bullestock/balancebot/pcb/balancebot.kicad_pcb

## KiCad design pcb/balancebot.kicad_pcb (2019-05-28)

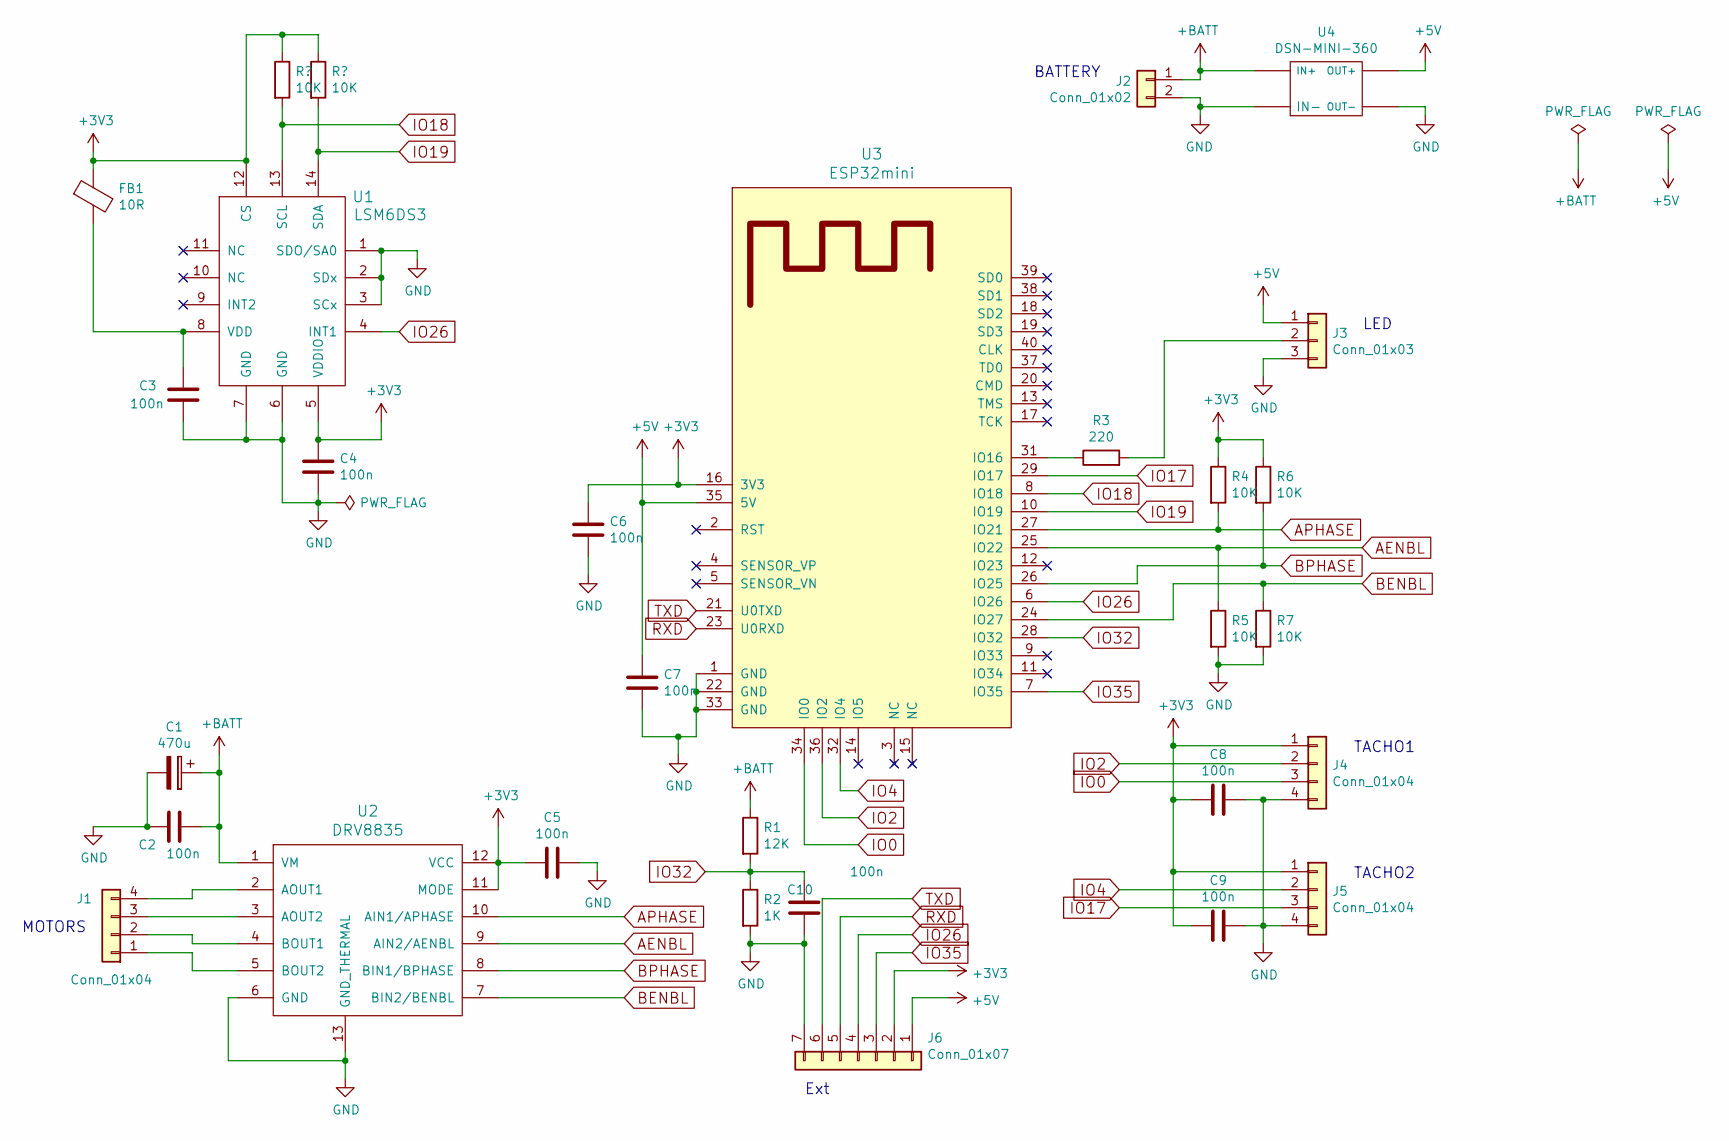
[picture p1: schematic balancebot.sch]

Parts:
C1: 470u; CP_Elec_8x10
C2, C3, C4, C5, C6, C7, C8, C9, C10: 100n; C_0603_1608Metric
FB1: 10R; L_0603_1608Metric
J1, J4, J5: Conn_01x04; JST_XH_B04B-XH-A_1x04_P2.50mm_Vertical
J2: Conn_01x02; JST_XH_B02B-XH-A_1x02_P2.50mm_Vertical
J3: Conn_01x03; JST_XH_B03B-XH-A_1x03_P2.50mm_Vertical
J6: Conn_01x07; JST_XH_B07B-XH-A_1x07_P2.50mm_Vertical
R1: 12K; R_0603_1608Metric
R2: 1K; R_0603_1608Metric
R3: 220; R_0603_1608Metric
R4, R5, R6, R7: 10K; R_0603_1608Metric
U1: LSM6DS3; LGA-14L
U2: DRV8835; WSON-12
U3: ESP32mini
U4: DSN-MINI-360

Connections:
+3V3: C4.1, C5.2, C6.1, C8.2, C9.2, FB1.1, J4.1, J5.1, J6.2, R4.1, R6.1, U1.5 (VDDIO), U1.12 (CS), U2.11 (MODE), U2.12 (VCC), U3.16 (3V3)
+5V: C7.1, J3.1, J6.1, U3.35 (5V), U4.OUT+
+BATT: C1.1, C2.1, J2.1, R1.1, U2.1 (VM), U4.IN+
AENBL: R5.1, U2.9 (AIN2/AENBL), U3.25 (IO22)
APHASE: R4.2, U2.10 (AIN1/APHASE), U3.27 (IO21)
BENBL: R7.1, U2.7 (BIN2/BENBL), U3.24 (IO27)
BPHASE: R6.2, U2.8 (BIN1/BPHASE), U3.26 (IO25)
GND: C1.2, C2.2, C3.2, C4.2, C5.1, C6.2, C7.2, C8.1, C9.1, C10.2, J2.2, J3.3, J4.4, J5.4, J6.7, R2.2, R5.2, R7.2, U1.1 (SDO/SA0), U1.2 (SDx), U1.3 (SCx), U1.6 (GND), U1.7 (GND), U2.6 (GND), U2.13 (GND_THERMAL), U3.1 (GND), U3.22 (GND), U3.33 (GND), U4.IN-, U4.OUT-
IO0: J4.3, U3.34 (IO0)
IO2: J4.2, U3.36 (IO2)
IO4: J5.2, U3.32 (IO4)
IO17: J5.3, U3.29 (IO17)
IO18: U1.13 (SCL), U3.8 (IO18)
IO19: U1.14 (SDA), U3.10 (IO19)
IO26: J6.4, U1.4 (INT1), U3.6 (IO26)
IO32: C10.1, R1.2, R2.1, U3.28 (IO32)
IO35: J6.3, U3.7 (IO35)
unnamed: C3.1, FB1.2, U1.8 (VDD)
unnamed: J1.1, U2.5 (BOUT2)
unnamed: J1.2, U2.4 (BOUT1)
unnamed: J1.3, U2.3 (AOUT2)
unnamed: J1.4, U2.2 (AOUT1)
unnamed: J3.2, R3.2
unnamed: R3.1, U3.31 (IO16)
RXD: J6.5, U3.23 (U0RXD)
TXD: J6.6, U3.21 (U0TXD)

Notes on the sheet:
LED
TACHO1
TACHO2
MOTORS
BATTERY
Ext

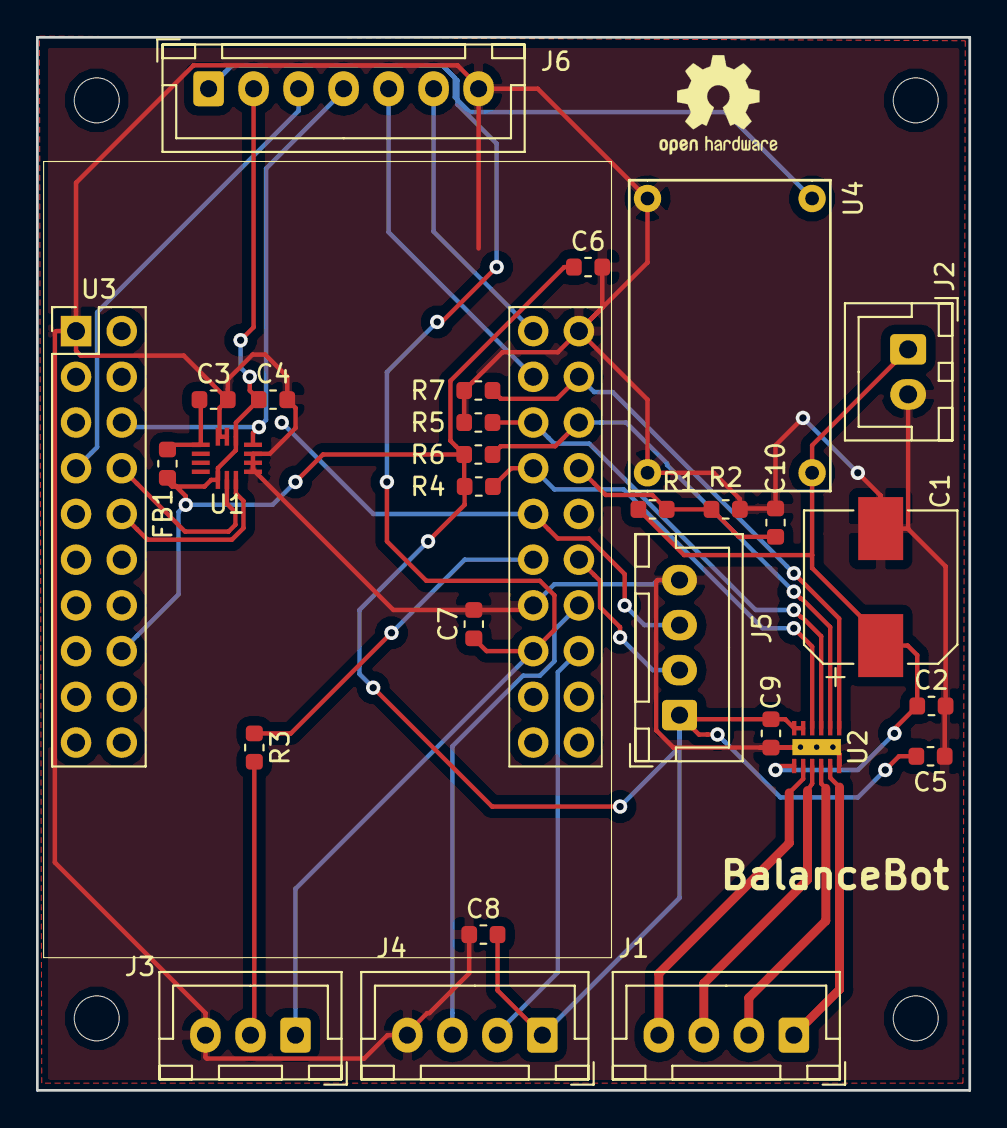
[picture p2: board balancebot.kicad_pcb from above]

Board: 2 copper layers, 51.8 x 58.5 mm, 28 parts (0 on the bottom side), 26 nets.
