bullestock/balancebot/esp32/main/main.cpp

#include <atomic>
#include <stdio.h>
#include <string.h>
#include <utility>

#include <freertos/FreeRTOS.h>
#include <freertos/queue.h>
#include <freertos/task.h>

#include <driver/adc.h>
#include <driver/ledc.h>
#include <driver/pcnt.h>

#include <lwip/sockets.h>

#include "esp_wifi.h"
#include "sdkconfig.h"
#include "esp_event.h"
#include "esp_sleep.h"
#include "nvs_flash.h"

#include "websocket_server.h"

#include "battery.h"
#include "console.h"
#include "espway.h"
#include "encoder.h"
#include "imu.h"
#include "imu_math.h"
#include "led.h"
#include "locks.h"
#include "motor.h"

#define LED_GPIO 16
#define LED_PIN 2 // internal

#define GPIO_APHASE_OUT 21
#define GPIO_AENBL_OUT  22
#define GPIO_BPHASE_OUT 25
#define GPIO_BENBL_OUT  27

#define GPIO_ENC_A1    2
#define GPIO_ENC_A2    0
#define GPIO_ENC_B1    4
#define GPIO_ENC_B2   17

#define PRIO_COMMUNICATION  2
#define PRIO_LED            0
#define PRIO_MAIN_LOOP      (TCPIP_THREAD_PRIO + 1)

Led* led = nullptr;
Motor* motor_a = nullptr;
Motor* motor_b = nullptr;
Encoder* enc_a = nullptr;
Encoder* enc_b = nullptr;
Imu* imu = nullptr;
Battery* battery = nullptr;
std::atomic<int32_t> looptime(0);

xQueueHandle pcnt_evt_queue;   // A queue to handle pulse counter events

mahony_filter_state imuparams;
static pidstate vel_pid_state;
static pidstate angle_pid_state;

SemaphoreHandle_t pid_mutex;
pidsettings pid_settings_arr[2];

static double target_speed = 0;
static double steering_bias = 0;

static SemaphoreHandle_t orientation_mutex;
vector3d gravity = {{ 0.0, 0.0, 1.0 }};

enum log_mode { LOG_FREQ, LOG_RAW, LOG_PITCH, LOG_NONE };

constexpr auto LOGMODE = LOG_FREQ;

#define ORIENTATION_STABILIZE_DURATION_US ((ORIENTATION_STABILIZE_DURATION) * 1000)
#define WINDUP_TIMEOUT_US ((WINDUP_TIMEOUT) * 1000)

static double sin_pitch = 0.0, sin_roll = 0.0;

static TaskHandle_t xCalculationTask = nullptr;

orientation get_orientation()
{
  orientation copy_orientation = {};
  {
    MutexLock lock(orientation_mutex);
    copy_orientation.sin_pitch = sin_pitch;
    copy_orientation.sin_roll = sin_roll;
  }
  return copy_orientation;
}

static SemaphoreHandle_t steering_mutex;

void set_steering(double new_target_speed, double new_steering_bias)
{
  {
    MutexLock lock(steering_mutex);
    target_speed = new_target_speed;
    steering_bias = new_steering_bias;
  }

  //!!if (xSteeringWatcher) xTaskNotify(xSteeringWatcher, 0, eNoAction);
}


double exponential_smooth(double prevVal, double newVal, double alpha)
{
    return prevVal + alpha * (newVal - prevVal);
}

int elapsed_time_us(TickType_t t2, TickType_t t1)
{
    return (t2 - t1)*portTICK_PERIOD_MS*1000;
}

void battery_cutoff()
{
    led->set_color(0, 0, 0);
    set_motors(0, 0);
    esp_deep_sleep_start();
}

void battery_task(void*)
{
    static bool shutdown = false;
    float smoothed_battery_value = battery->read_voltage();
    int send_counter = 0;
    while (1)
    {
        smoothed_battery_value = exponential_smooth(smoothed_battery_value, battery->read_voltage(), 0.05);
        if (smoothed_battery_value < BATTERY_THRESHOLD)
        {
            if (ENABLE_BATTERY_CUTOFF)
            {
                battery_cutoff();
                // Terminate task
                break;
            }
            else
            {
                disable_motors();
                if (!shutdown)
                {
                    led->set_color(0, 0, 0);
                    shutdown = true;
                    printf("SHUTDOWN: %f\n", smoothed_battery_value);
                }
            }
        }

        if (++send_counter > 20)
        {
            send_counter = 0;
            uint8_t buf[3];
            buf[0] = BATTERY;
            uint16_t* payload = (uint16_t*) &buf[1];
            payload[0] = static_cast<uint16_t>(smoothed_battery_value*1000);
            ws_server_send_bin_all(buf, sizeof(buf));
        }
        vTaskDelay(BATTERY_CHECK_INTERVAL / portTICK_PERIOD_MS);
    }
}

void steering_watcher(void *arg)
{
    while (1)
        if (!xTaskNotifyWait(0, 0, NULL, STEERING_TIMEOUT_MS / portTICK_PERIOD_MS))
        {
            steering_bias = 0;
            target_speed = 0;
        }
}

void led_task(void*)
{
    while (1)
    {
        led->update();
        vTaskDelay(100 / portTICK_PERIOD_MS);
    }
}

std::atomic<state> my_state(STABILIZING_ORIENTATION);
TickType_t stage_started = 0;
double smoothed_target_speed = 0;
double travel_speed = 0;
TickType_t last_wind_up = 0;
int64_t a_distance = 0;
int64_t b_distance = 0;
int a_speed = 0;
int b_speed = 0;

void init()
{
    my_state = STABILIZING_ORIENTATION;
    const TickType_t current_time = xTaskGetTickCount();
    stage_started = current_time;
    smoothed_target_speed = 0;
    travel_speed = 0;
    last_wind_up = current_time;
}

void main_loop(void* pvParameters)
{
    TickType_t time_last = xTaskGetTickCount();
    TickType_t current_time = 0;
    int n = 0;

    init();

    int loopcount = 0;
#define SHOW_DEBUG() 0 // (my_state == RUNNING)// && (loopcount == 0))

    led->set_color(Led::Init);

    int64_t last_enc_a_pos = 0;
    int64_t last_enc_b_pos = 0;
    
    while (1)
    {
        xTaskNotifyWait(0, 0, NULL, 1); // allow other tasks to run

        ++loopcount;
        if (loopcount >= 100)
        {
            loopcount = 0;

            const int64_t enc_a_pos = enc_a->poll();
            const int64_t enc_b_pos = enc_b->poll();
            a_speed = static_cast<int>(last_enc_a_pos - enc_a_pos);
            b_speed = static_cast<int>(last_enc_b_pos - enc_b_pos);
            last_enc_a_pos = enc_a_pos;
            last_enc_b_pos = enc_b_pos;
            a_distance += a_speed;
            b_distance += b_speed;
        }

        // 700 us
        int16v3 raw_data_accel, raw_data_gyro;
        if (!imu->read_raw_data(raw_data_accel, raw_data_gyro))
        {
            printf("Reading IMU failed\n");
            continue;
        }

        // Update orientation estimate
        // < 100 us
        {
            MutexLock lock(orientation_mutex);
            mahony_filter_update(&imuparams, raw_data_accel, raw_data_gyro, gravity);
            // Calculate sine of pitch angle from gravity vector
            sin_pitch = -gravity.data[IMU_FORWARD_AXIS];
            if (IMU_INVERT_FORWARD_AXIS)
                sin_pitch = -sin_pitch;
            sin_roll = -gravity.data[IMU_SIDE_AXIS];
            if (IMU_INVERT_SIDE_AXIS)
                sin_roll = -sin_roll;
        }

        // Exponential smoothing of target speed
        
        double motor_bias;
        {
            MutexLock lock(orientation_mutex);
            smoothed_target_speed = exponential_smooth(smoothed_target_speed,
                                                       target_speed, TARGET_SPEED_SMOOTHING);
            motor_bias = steering_bias;
        }

        current_time = xTaskGetTickCount();

        //printf("sin_pitch %f sin_roll %f\n", sin_pitch, sin_roll);
        
        if (my_state == STABILIZING_ORIENTATION &&
            elapsed_time_us(current_time, stage_started) > ORIENTATION_STABILIZE_DURATION_US)
        {
            led->set_color(Led::Stabilized);
            printf("Done stabilizing at %u\n", current_time);
            printf("sin_pitch %f sin_roll %f\n", sin_pitch, sin_roll);
            my_state = RUNNING;
            last_wind_up = current_time;
            imuparams.Kp = MAHONY_FILTER_KP;
        }
        else if (my_state == WOUND_UP)
        {
            if (fabs(sin_pitch - STABLE_ANGLE) < RECOVER_LIMIT)
            {
                printf("Try again!\n");
                init();
            }
        }
        else if (my_state == RUNNING)
        {
            if (fabs(sin_pitch - STABLE_ANGLE) < FALL_LIMIT &&
                fabs(sin_roll) < ROLL_LIMIT)
            {
                // Perform PID update
                double target_angle, motor_speed;
                {
                    MutexLock lock(pid_mutex);
                    target_angle = pid_compute(travel_speed, smoothed_target_speed,
                                               &pid_settings_arr[VEL], &vel_pid_state,
                                               SHOW_DEBUG());
                    if (sin_pitch < (target_angle - HIGH_PID_LIMIT))
                        motor_speed = -1.0;
                    else if (sin_pitch > target_angle + HIGH_PID_LIMIT)
                        motor_speed = 1.0;
                    else
                        motor_speed = pid_compute(sin_pitch, target_angle,
                                                  &pid_settings_arr[ANGLE], &angle_pid_state,
                                                  SHOW_DEBUG());
                    if (SHOW_DEBUG())
                        printf("Angle Kp %f motor_speed %f\n", pid_settings_arr[ANGLE].Kp, motor_speed);
                }

                if (fabs(motor_speed) < MOTOR_DEADBAND)
                    motor_speed = 0;

                if (my_state == WOUND_UP)
                    set_motors(0, 0);
                else
                    set_motors(motor_speed + motor_bias,
                               motor_speed - motor_bias);

                if (motor_speed != 1.0 && motor_speed != -1.0)
                    last_wind_up = current_time;
                else
                {
                    const auto us_since_last_windup = elapsed_time_us(current_time, last_wind_up);
                    if (us_since_last_windup > WINDUP_TIMEOUT_US)
                    {
                        set_motors(0, 0);
                        if (my_state != WOUND_UP)
                            printf("WOUND UP at %u (%d)\n", current_time, us_since_last_windup);
                        my_state = WOUND_UP;
                        led->set_colors(100, Led::WoundUp, Led::None);
                        //vTaskDelay(100/portTICK_PERIOD_MS);
                    }
                }

                // Estimate travel speed by exponential smoothing
                travel_speed = exponential_smooth(travel_speed, motor_speed,
                                                  TRAVEL_SPEED_SMOOTHING);
            }
            else
            {
                printf("FALLEN!\n");
                my_state = FALLEN;
                led->set_colors(50, Led::Fallen, Led::None);
                travel_speed = 0;
                smoothed_target_speed = 0;
                set_motors(0, 0);
            }
        }
        else if (my_state == FALLEN &&
                 fabs(sin_pitch - STABLE_ANGLE) < RECOVER_LIMIT &&
                 fabs(sin_roll) < ROLL_LIMIT)
        {
            printf("Running again!\n");
            my_state = RUNNING;
            last_wind_up = current_time;
            led->set_color(Led::Running);
            pid_reset(sin_pitch, 0, &pid_settings_arr[ANGLE], &angle_pid_state);
            pid_reset(0, STABLE_ANGLE, &pid_settings_arr[VEL],
                      &vel_pid_state);
        }

        if (LOGMODE == LOG_FREQ)
        {
            ++n;
            if (n == 1000)
            {
                n = 0;
                const auto now = xTaskGetTickCount();
                looptime = elapsed_time_us(now, time_last);
                time_last = now;
            }
        }
        else if (LOGMODE == LOG_RAW)
        {
            printf("%d, %d, %d, %d, %d, %d\n",
                   raw_data_accel[0], raw_data_accel[1], raw_data_accel[2],
                   raw_data_gyro[0], raw_data_gyro[1], raw_data_gyro[2]);
        }
        else if (LOGMODE == LOG_PITCH)
        {
            printf("%f, %f\n", sin_pitch, sin_roll);
        }

        //!!xTaskNotify(xIMUWatcher, 0, eNoAction);
    }
}

void event_handler(void*, esp_event_base_t event_base,
                   int32_t event_id, void* event_data)
{
    printf("WiFi event: %d\n", event_id);
}

static void wifi_setup()
{
    esp_netif_init();
    ESP_ERROR_CHECK(esp_event_loop_create_default());

    // Don't run a DHCP client
    esp_netif_t* my_ap = esp_netif_create_default_wifi_ap();
    esp_netif_dhcpc_stop(my_ap);

    esp_netif_ip_info_t ipInfo;
    IP4_ADDR(&ipInfo.ip, 10, 0, 0, 1);
	IP4_ADDR(&ipInfo.gw, 10, 0, 0, 1);
	IP4_ADDR(&ipInfo.netmask, 255, 255, 255, 0);
	esp_netif_dhcps_stop(my_ap);
	esp_netif_set_ip_info(my_ap, &ipInfo);
	ESP_ERROR_CHECK(esp_netif_dhcps_start(my_ap));
    
    wifi_init_config_t cfg = WIFI_INIT_CONFIG_DEFAULT();
    ESP_ERROR_CHECK(esp_wifi_init(&cfg));
    ESP_ERROR_CHECK(esp_event_handler_instance_register(WIFI_EVENT,
                                                        ESP_EVENT_ANY_ID,
                                                        &event_handler,
                                                        NULL,
                                                        NULL));
    ESP_ERROR_CHECK(esp_wifi_set_storage(WIFI_STORAGE_RAM));
    ESP_ERROR_CHECK(esp_wifi_set_mode(WIFI_MODE_AP));
    wifi_config_t ap_config = {};
    strcpy((char*) ap_config.ap.ssid, WIFI_SSID);
    ap_config.ap.ssid_len = strlen(WIFI_SSID);
    strcpy((char*) ap_config.ap.password, CONFIG_WIFI_PASS);
    ap_config.ap.authmode = WIFI_AUTH_WPA2_PSK;
    ap_config.ap.max_connection = 1;
    ap_config.ap.beacon_interval = 100;
    ESP_ERROR_CHECK(esp_wifi_set_config(WIFI_IF_AP, &ap_config));
    ESP_ERROR_CHECK(esp_wifi_start());
}

extern void server_task(void* pvParameters);
extern void server_handle_task(void* pvParameters);

extern "C"
void app_main()
{
    led = new Led(LED_GPIO);
    led->set_color(0, 0, 0);

    pid_mutex = xSemaphoreCreateMutex();
    orientation_mutex = xSemaphoreCreateMutex();
    steering_mutex = xSemaphoreCreateMutex();

    nvs_flash_init();
    load_config();
    apply_config_params();
    pretty_print_config();

    // Parameter calculation & initialization
    pid_reset(0, 0, &pid_settings_arr[ANGLE], &angle_pid_state);
    pid_reset(0, 0, &pid_settings_arr[VEL], &vel_pid_state);
    mahony_filter_init(&imuparams, 10.0f * MAHONY_FILTER_KP, MAHONY_FILTER_KI,
                       2.0 * 2000.0f * M_PI / 180.0f, IMU_SAMPLE_TIME);

    imu = new Imu();
    motor_a = new Motor(MCPWM_UNIT_0, MCPWM_TIMER_0, MCPWM0A, MCPWM0B, GPIO_AENBL_OUT, GPIO_APHASE_OUT);
    motor_b = new Motor(MCPWM_UNIT_0, MCPWM_TIMER_1, MCPWM1A, MCPWM1B, GPIO_BENBL_OUT, GPIO_BPHASE_OUT);
    battery = new Battery;
    enc_a = new Encoder(PCNT_UNIT_0, GPIO_ENC_A1, GPIO_ENC_A2);
    enc_b = new Encoder(PCNT_UNIT_1, GPIO_ENC_B1, GPIO_ENC_B2);
    
    xTaskCreate(&led_task, "led_task", 2048, NULL, PRIO_LED, NULL);

    printf("Press a key to enter console\n");
    bool debug = false;
    for (int i = 0; i < 20; ++i)
    {
        if (getchar() != EOF)
        {
            debug = true;
            break;
        }
        vTaskDelay(100/portTICK_PERIOD_MS);
    }
    if (debug)
        run_console();        // never returns
    printf("\nStarting application\n");
    
    wifi_setup();
    ws_server_start();
    xTaskCreate(&battery_task, "Battery task", 2048, NULL, PRIO_COMMUNICATION, NULL);
    xTaskCreate(&server_task, "HTTP Daemon", 3000, NULL, PRIO_COMMUNICATION, NULL);
    xTaskCreate(&server_handle_task, "server_handle_task", 4000, NULL, PRIO_COMMUNICATION, NULL);

    xTaskCreate(&main_loop, "Main loop", 10240, NULL, PRIO_MAIN_LOOP, &xCalculationTask);
    //xTaskCreate(&steering_watcher, "Steering watcher", 128, NULL, PRIO_MAIN_LOOP + 1, &xSteeringWatcher);
}
