bullestock/balancebot/esp32/main/config.cpp

/*
 * Firmware for a segway-style robot using ESP32.
 * Copyright (C) 2017  Sakari Kapanen
 *
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
 * You should have received a copy of the GNU Lesser General Public License
 * along with this program.  If not, see <http://www.gnu.org/licenses/>.
 */

#include <stdio.h>

#include <freertos/FreeRTOS.h>

#include "nvs_flash.h"

#include "locks.h"
#include "espway.h"

espway_config my_config;

const static espway_config DEFAULT_CONFIG = {
    .pid_coeffs_arr = {
        { ANGLE_KP, ANGLE_KI, ANGLE_KD },
        { VEL_KP, VEL_KI, VEL_KD }
    },
    .gyro_offsets = { GYRO_X_OFFSET, GYRO_Y_OFFSET, GYRO_Z_OFFSET }
};

void pretty_print_config()
{
    MutexLock lock(pid_mutex);
    printf("\n\nESPway current config:\n\n"
           "ANGLE_KP %f\n"
           "ANGLE_KI %f\n"
           "ANGLE_KD %f\n"
           "VEL_KP %f\n"
           "VEL_KI %f\n"
           "VEL_KD %f\n"
           "GYRO_X_OFFSET %d\n"
           "GYRO_Y_OFFSET %d\n"
           "GYRO_Z_OFFSET %d\n"
           "\n\n",
           my_config.pid_coeffs_arr[ANGLE].p,
           my_config.pid_coeffs_arr[ANGLE].i,
           my_config.pid_coeffs_arr[ANGLE].d,
           my_config.pid_coeffs_arr[VEL].p,
           my_config.pid_coeffs_arr[VEL].i,
           my_config.pid_coeffs_arr[VEL].d,
           my_config.gyro_offsets[0],
           my_config.gyro_offsets[1],
           my_config.gyro_offsets[2]
  );
}

void load_hardcoded_config()
{
    my_config = DEFAULT_CONFIG;
}

void load_config()
{
    MutexLock lock(pid_mutex);
    load_hardcoded_config();

    nvs_handle h;
    ESP_ERROR_CHECK(nvs_open("espway", NVS_READWRITE, &h));
    size_t size = sizeof(pid_coeffs);
    nvs_get_blob(h, "ANGLE_PID", (uint8_t*) &my_config.pid_coeffs_arr[ANGLE], &size);
    nvs_get_blob(h, "VEL_PID", (uint8_t*) &my_config.pid_coeffs_arr[VEL], &size);
    size = sizeof(my_config.gyro_offsets);
    nvs_get_blob(h, "GYRO_OFFSETS", (uint8_t*) &my_config.gyro_offsets, &size);
}

void apply_config_params()
{
    MutexLock lock(pid_mutex);
    pid_initialize(&my_config.pid_coeffs_arr[ANGLE],
                   IMU_SAMPLE_TIME,
                   -1.0, 1.0, false, &pid_settings_arr[ANGLE]);
    pid_initialize(&my_config.pid_coeffs_arr[VEL],
                   IMU_SAMPLE_TIME,
                   STABLE_ANGLE - FALL_LIMIT, STABLE_ANGLE + FALL_LIMIT, true,
                   &pid_settings_arr[VEL]);
}

bool save_flash_config()
{
    MutexLock lock(pid_mutex);

    nvs_handle h;
    ESP_ERROR_CHECK(nvs_open("espway", NVS_READWRITE, &h));
    size_t size = sizeof(pid_coeffs);
    bool success = (nvs_set_blob(h, "ANGLE_PID", (uint8_t*) &my_config.pid_coeffs_arr[ANGLE], size) == ESP_OK);
    if (success)
        success = (nvs_set_blob(h, "VEL_PID", (uint8_t*) &my_config.pid_coeffs_arr[VEL], size) == ESP_OK);
    size = sizeof(my_config.gyro_offsets);
    if (success)
        success = (nvs_set_blob(h, "GYRO_OFFSETS", (uint8_t*) &my_config.gyro_offsets, size) == ESP_OK);

    return success;
}

bool clear_flash_config()
{
    nvs_handle h;
    ESP_ERROR_CHECK(nvs_open("espway", NVS_READWRITE, &h));
    return (nvs_erase_key(h, "ANGLE_PID") == ESP_OK) &&
        (nvs_erase_key(h, "VEL_PID") == ESP_OK) &&
       (nvs_erase_key(h, "GYRO_OFFSETS") == ESP_OK);
}

void update_pid_controller(pid_controller_index idx, double p, double i, double d)
{
    if (idx > 2)
        return;

    MutexLock lock(pid_mutex);
    pid_coeffs *p_coeffs = &my_config.pid_coeffs_arr[idx];
    p_coeffs->p = p;
    p_coeffs->i = i;
    p_coeffs->d = d;
    pid_update_params(p_coeffs, &pid_settings_arr[idx]);
}
