bullestock/balancebot/(commit log)

2018-04-07 Add case.
2018-04-08 Make room for wheels.
2018-04-10 Ungroup to make LasaurApp work properly. Add battery support.
2018-04-13 Fix size of wheel covers.
2018-04-13 Add LED test code.
2018-04-14 Add motor task.
2018-04-14 Control both motors.
2018-04-18 Add encoder test code.
2018-04-18 Add second encoder.
2018-06-19 Implement IMU config and register read.
2018-06-24 Fix motor B direction.
    [main.cpp]
2018-07-21 Add battery task; enable main task again.
2018-07-21 Move battery_task() to main.cpp.
2018-07-21 Fix battery scale factor.
    [config.h]
2018-07-21 Fix handling of PID coefficients.
    [server.cpp]
2018-07-21 Fix more conversion issues.
    [main.cpp, server.cpp]
2018-08-03 Increase I2C frequency to 1 MHz.
2018-10-21 Add schematic.
    [balancebot.kicad_pcb, balancebot.sch]
2018-10-24 Fix ESP32 footprint.
    [balancebot.kicad_pcb, balancebot.sch]
2018-10-26 Complete routing.
    [balancebot.kicad_pcb, balancebot.sch]
2018-10-26 Make pretty.
    [balancebot.kicad_pcb]
2018-10-27 Update ESP32 footprint; make motor traces wider.
    [balancebot.kicad_pcb]
2018-10-27 Finalize PCB.
    [balancebot-B.Cu.gbr, balancebot-B.Mask.gbr, balancebot-B.Paste.gbr, balancebot-B.SilkS.gbr, balancebot-Edge.Cuts.gbr, balancebot-F.Cu.gbr, balancebot-F.Mask.gbr, balancebot-F.Paste.gbr]
2018-10-28 Change WSON-12 via to 0.3 mm.
    [balancebot-B.Cu.gbr, balancebot-B.Mask.gbr, balancebot-B.Paste.gbr, balancebot-B.SilkS.gbr, balancebot-Edge.Cuts.gbr, balancebot-F.Cu.gbr, balancebot-F.Mask.gbr, balancebot-F.Paste.gbr]
2019-05-28 Start using LSM6DS3 driver from mjstn/MarkWorldCodeModules.
    [balancebot.kicad_pcb, balancebot.sch]
2019-05-29 Use MarkWorld driver.
2019-05-31 Make motor control work.
2019-06-05 Show averaged IMU readings.
2019-06-08 Add LED test.
2019-06-08 Fix NUL bytes in HTML/JS.
    [server.cpp]
2019-06-08 Fix detection of wound up state.
    [main.cpp]
2019-06-15 Add battery check.
2019-07-17 Disable motors when running on USB power.
2019-07-27 Fix LSM6DS3 settings to match espway project.
    [lsm6ds3_driver.cpp]
2019-07-31 Fix forward axis direction.
    [config.h]
2019-07-31 New case with round top.
2019-08-07 Use only predefined colours for LED test.
2019-08-07 Disable battery cutoff.
2019-08-14 Show wired IP on line 0.
2019-08-14 Move Display to separate file; show battery voltage.
2019-08-31 Use separate scaling factors for steering and speed.
2019-09-01 Reset steering after a period with no user input.
    [wiiboard_connector.py]
2019-09-21 Reset steering on Wiiboard inactivity.
    [wiiboard_connector.py]
2019-10-25 Battery box, initial
2019-11-17 Start new case design.
2019-11-17 Fix placement of bottom slots.
2019-11-17 Add mountplate.
2019-11-17 Center switch.
2019-11-17 Add holes for battery compartment sides.
2019-12-27 Remove old case parts.
2020-01-11 Make battery fit tighter.
2020-01-11 Rework LED driver.
2020-01-18 Add hole.
2021-05-09 Get PID coefficients on startup.
2021-05-15 Send battery message less often.
2021-05-19 Make reset button work.
2021-05-20 Enable encoder task.
2021-09-08 Fix encoder handling bugs.
    [console.cpp, main.cpp, server.cpp]
